creid89/ECE411_Group_Project/Schematics/Prototype V1.png

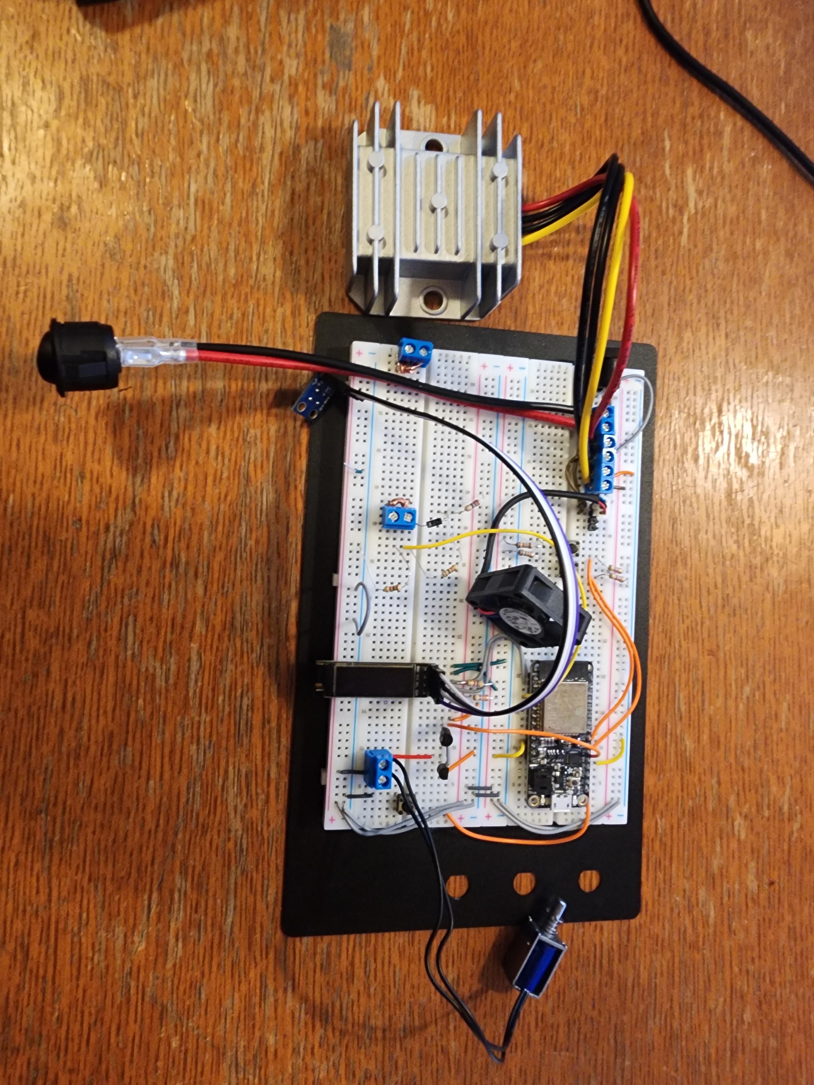
Schematics/Prototype V1.png
