creid89/ECE411_Group_Project/README.md

# ECE411_Group_Project
A repository for our PSU ECE411 Practicum Project
