creid89/ECE411_Group_Project/ESP32 Code/README

Add Revision of ESP32 Code for the ChargeGaurd Pro+ In this Folder
