creid89/ECE411_Group_Project/Weekly HW/Team 2 - 411 - L1 Functional Decomposition.pptx

Level 0

Lithium-Ion charge Button

Level 0
Module | ChargeGuard Pro+
Inputs | Power 12V, Lithium-ion Button, Alkaline button, reset button, Temperature sensor
Output | AA Alkaline battery, Lithium-ion button cell (2032 or 2025) , 12V Fan, LCD indicator
Functionality | Uses 12V power source to charge either a lithium-ion button cell or Alkaline AA batteries. Should include an LCD indicator to display temperature.

AA Alkaline battery

Power 12V

ChargeGuard Pro+

LCD indicator

Reset Button

Fan

Alkaline Button

Lithium-ion button cell (2032/2025)

Temperature sensor

## Slide 2

Level 1 - ChargeGuard Pro+

Start/Stop Switch (AA)

Start/Stop Switch (BC)

Voltage (AA)

Current AA Voltage

Current BC Voltage

SDA/SCL Signal

OLED Screen

User Feedback

Battery Temp

Voltage (BC)

AA Voltage Divider

BC Voltage Divider

Temperature Sensor

Huzzah_ESP32 Module

GPIO Charge Start Signal

SDA/SCL Signal

GPIO Charge Start Signal

Solenoid

AA Charge module

Battery Charge

Reset

BC Charge module

Battery Charge

Power (12V)

Voltage Regulator (5V out)

5VDC

GPIO Battery Eject Signal

Eject AA battery

## Slide 3

AA Voltage Divider: Level 1

AA Voltage Divider

Voltage (AA) ADC (to Huzzah_ESP32)

Voltage (AA)

Level 1
Module | AA Voltage Divider
Inputs | AA Battey Voltage
Output | AA Battery Voltage
Functionality | Use a voltage divider to measure current value of AA battery voltage

## Slide 4

BC Voltage Divider: Level 1

BC Voltage Divider

Voltage (BC) (to Huzzah_ESP32

Voltage (BC)

Level 1
Module | BC Voltage Divider
Inputs | BC Battey Voltage
Output | BC Battery Voltage
Functionality | Use a voltage divider to measure current value of BC battery voltage

## Slide 5

Temperature Sensor: Level 1

Temperature Sensor

5VDC

SDA (to Huzzah_ESP32)

Battery Temperature (°C)

SCL (to Huzzah_ESP32)

Level 1
Module | Temperature Sensor
Inputs | 5VDC (power supply), Battery Temperature measured in °C
Output | SDA/SCL to the Huzzah_ESP32
Functionality | Measure temperature of battery that is currently being charged, read using the ESP32 I2C bus

## Slide 6

OLED Screen: Level 1

OLED Screen

5VDC

Battery Temperature

SDA (from Huzzah_ESP32)

Battery Voltage

SDL (from Huzzah_ESP32)

Current System State

Level 1
Module | OLED Screen
Inputs | 5VDC (power supply), SDA/SCL from the Huzzah_ESP32
Output | Battery temperature, battery voltage
Functionality | Display current system information to user via OLED Screen

## Slide 7

Solenoid: Level 1

Solenoid

GPIO Start Signal

5VDC

Actuating Armature

Level 1
Module | Solenoid
Inputs | 5VDC
Output | Actuating Armature
Functionality | When the battery is done charging, using the armature to eject the charged battery

## Slide 8

Huzzah_ESP32: Level 1

Huzzah_ESP32

Start/Stop Button (BC)

Start/Stop Button (AA)

Solenoid Start/Stop Signal

BC Battery Voltage

BC Charge Module Start/Stop Signal

AA Battery Voltage

AA Charge Module Start/Stop Signal

SDA/SCL From Temp Sensor

RESET

SDA/SDL to OLED

5 VDC

Level 1
Module | Huzzah_ESP32
Inputs | Start/Stop Charge Button (Qty. (1) for each AA and BC batteries), BC/AA Current Voltage, SDA/SCL from temp sensor, Reset, 5VDC from regulator to power uC
Output | Solenoid start/stop signal, BC and AA charge module Start/Stop charging signal, SDA/SCL to user OLED display
Functionality | Continuously read and store current values for temperature, voltage, and button states. Send signals to start/stop charging based on input thresholds and system state. Display real-time system status: temperature, voltage, charging state, and errors. Transition between states (e.g., charging, waiting, error) based on input conditions and thresholds.

## Slide 9

Voltage Regulator : Level 1

Voltage Regulator

12 VDC

5 VDC

Level 1
Module | Voltage Regulator
Inputs | 12 VDC (from 12VDC wall wart)
Output | 5 VDC
Functionality | Steps down 12VDC input to a stable 5VDC output.

## Slide 10

AA Charge Module: Level 1

AA Charge Module

GPIO Pin Start Signal (From Huzzah_ESP32

(1.3 – 1.6) VDC

Level 1
Module | AA Charging Module
Inputs | Start Charging Signal
Output | (1.3 – 1.6) VDC Charging Voltage
Functionality | Starts charging AA battery when a start signal comes from the Huzzah_ESP32

## Slide 11

BC Charge Module: Level 1

BC Charge Module

GPIO Pin Start Signal (From Huzzah_ESP32

4.2 VDC

Level 1
Module | BC Charging Module
Inputs | Start Charging Signal
Output | 4.2 VDC Charging Voltage
Functionality | Starts charging BC battery when a start signal comes from the Huzzah_ESP32
