creid89/ECE411_Group_Project/Weekly Progress Reports (WPRs)/Progress Report - Week 7 .pdf

## Progress Report - Week 7 | Nov. 9, 2024

Group 2:

Cody Reid
Cuauhtemoc Gomez Angeles
Daniel Anishchenko
Tyler Tran

This Week’s Assignments:
- Updated CAD
- Bill of Materials
- Functional Decomp

Meeting Notes:
- Currently testing a larger OLED screen, will decide later as a team if the smaller one will be replaced
- Gantt chart should be finished by 12:30 am - Nov. 2
- Work is divided as follows
- Cody is to work on functional Decomposition
- Tyler is to work on the BOM
- Daniel is working on the breadboard
- Vincente is working on the BOM and CAD

Completed Tasks:
- Updated CAD - completed Nov. 9
- Bill of Materials - completed Nov.11
- Functional Decomp - completed Nov. 9 Tasks at Hand (Priority High to Low):
- Start finalizing code
- Start on final PCB CAD
- Revise 2nd phase prototype casing
