creid89/ECE411_Group_Project/Component Info/README

A place to store components informations such as technical documnentation, pinouts, ect
