creid89/ECE411_Group_Project/Schematics/Screen Cover V2.stl

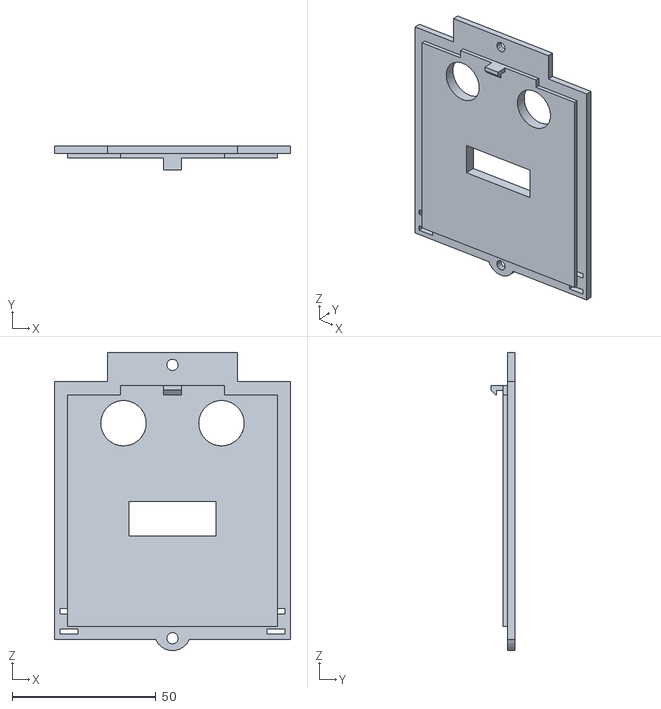
[picture p5: CAD file, 2024-12-10]
Schematics/Screen Cover V2.stl
82.3 x 8.33 x 103.8
