creid89/ECE411_Group_Project/Schematics/Battery Terminal Bracket V1 PRINT NOW 12-4-2024.stl

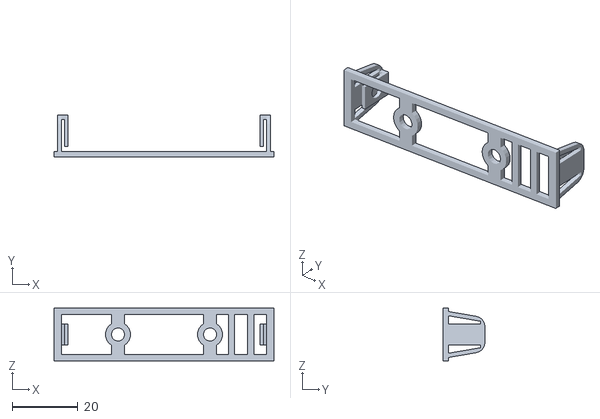
[picture p6: CAD file, 2024-12-05]
Schematics/Battery Terminal Bracket V1 PRINT NOW 12-4-2024.stl
66.8 x 12.7 x 16.0
