creid89/ECE411_Group_Project/Schematics/Bottom Legs - Print now 11-30-2024.stl

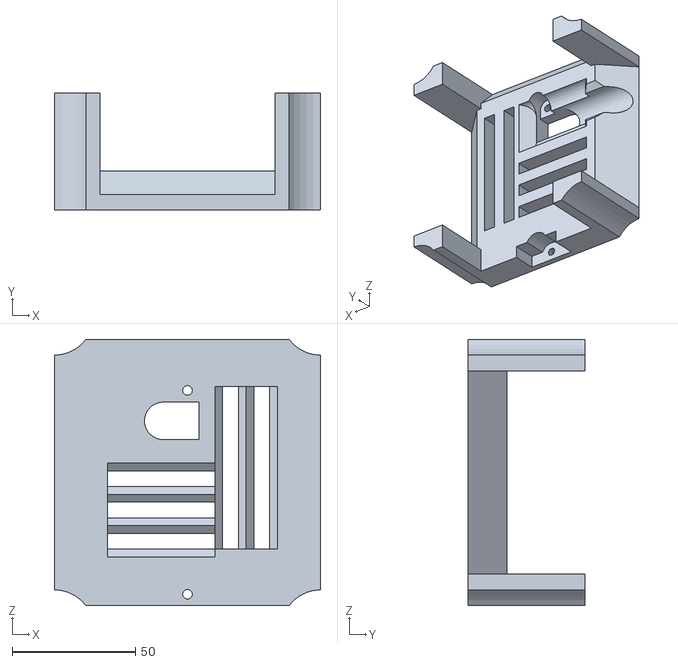
[picture p7: CAD file, 2024-11-30]
Schematics/Bottom Legs - Print now 11-30-2024.stl
107.9 x 47.6 x 108.0
