creid89/ECE411_Group_Project/Schematics/Legs V1.stl

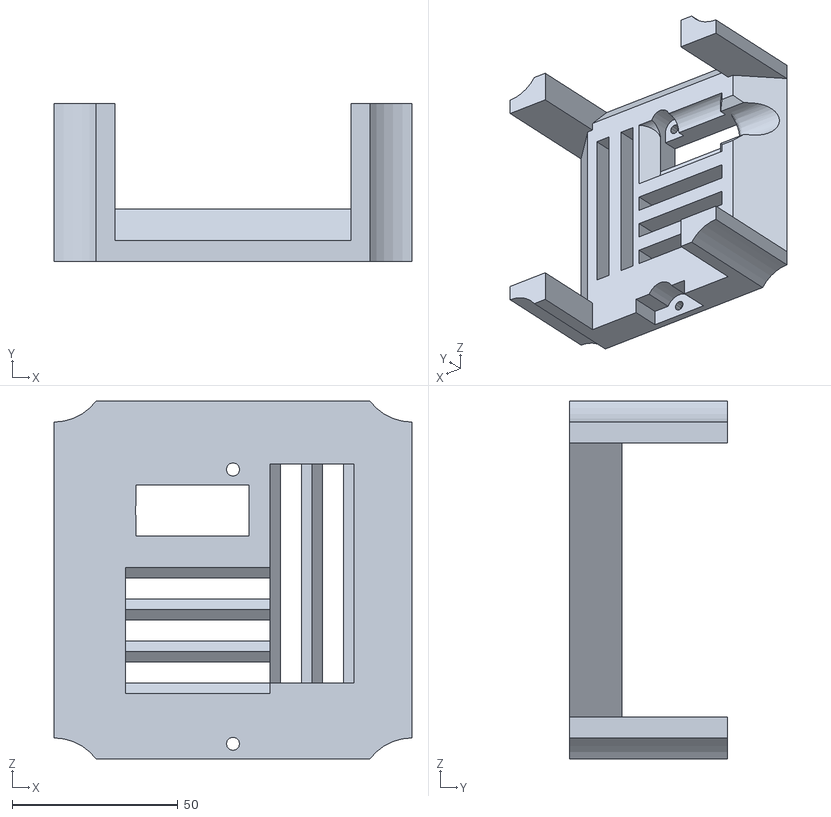
[picture p8: CAD file, 2024-11-20]
Schematics/Legs V1.stl
107.9 x 47.6 x 108.0
