creid89/ECE411_Group_Project/Schematics/Housing Bottom V3.stl

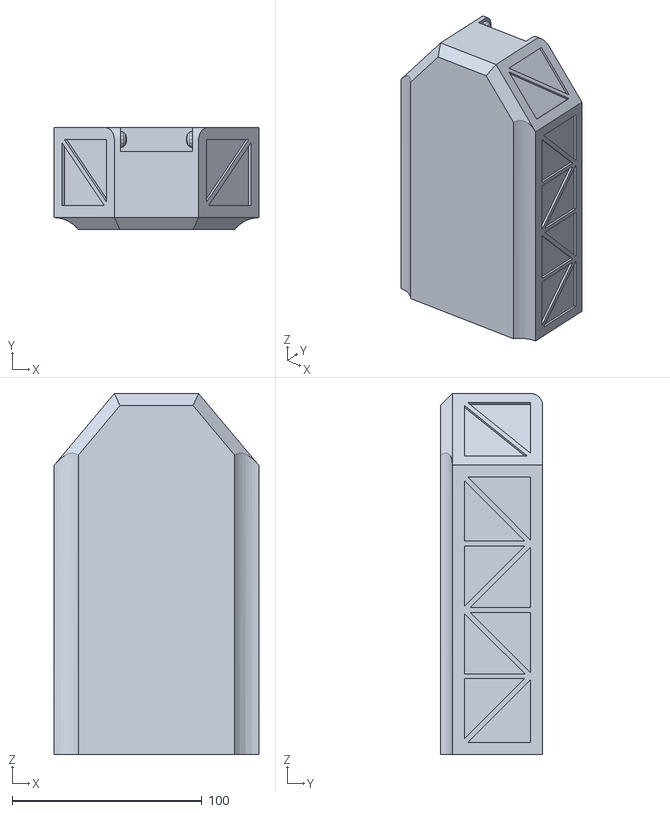
[picture p9: CAD file, 2024-11-20]
Schematics/Housing Bottom V3.stl
107.9 x 54.0 x 190.5
