creid89/ECE411_Group_Project/Schematics/Grid V3.stl

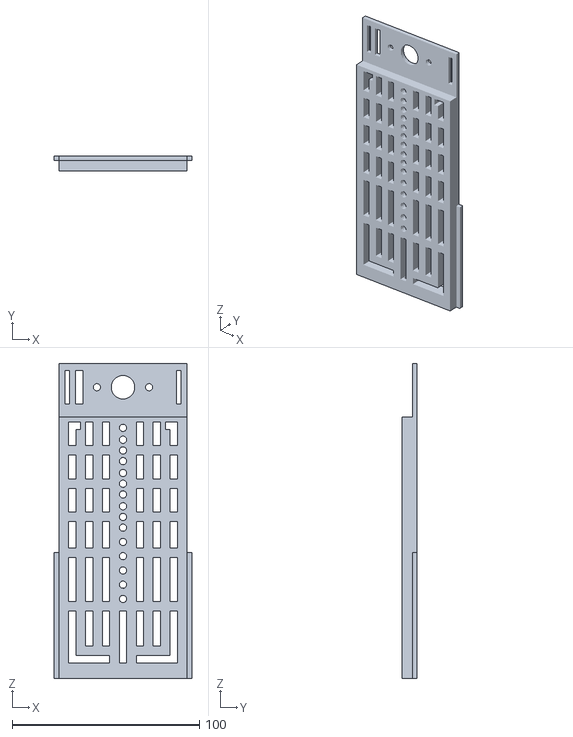
[picture p10: CAD file, 2024-11-20]
Schematics/Grid V3.stl
73.7 x 8.26 x 168.4
