creid89/ECE411_Group_Project/Schematics/Housing Top V2.stl

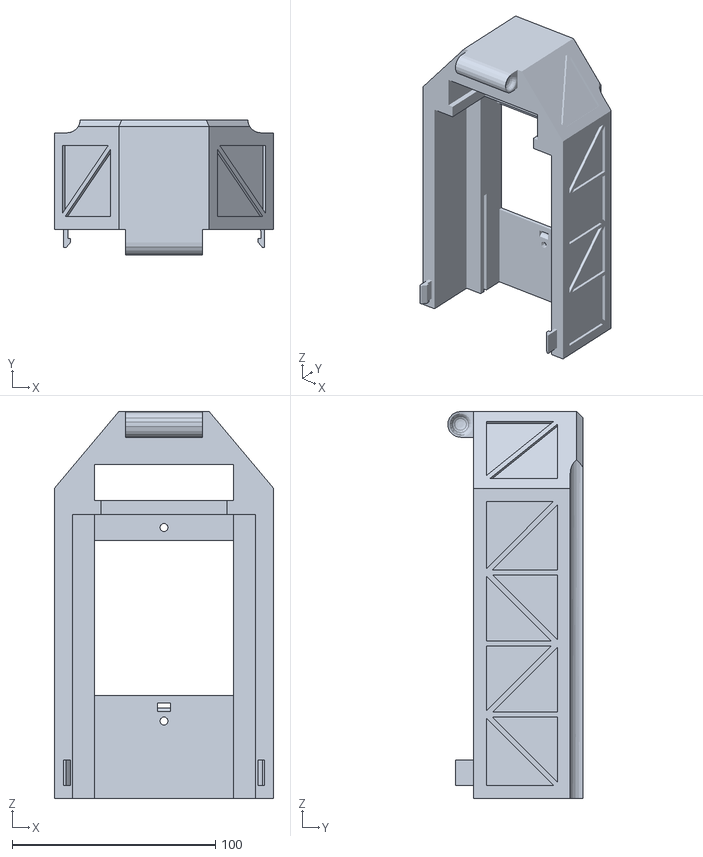
[picture p11: CAD file, 2024-11-20]
Schematics/Housing Top V2.stl
107.9 x 66.6 x 190.5
