creid89/ECE411_Group_Project/Schematics/Housing V2.stl

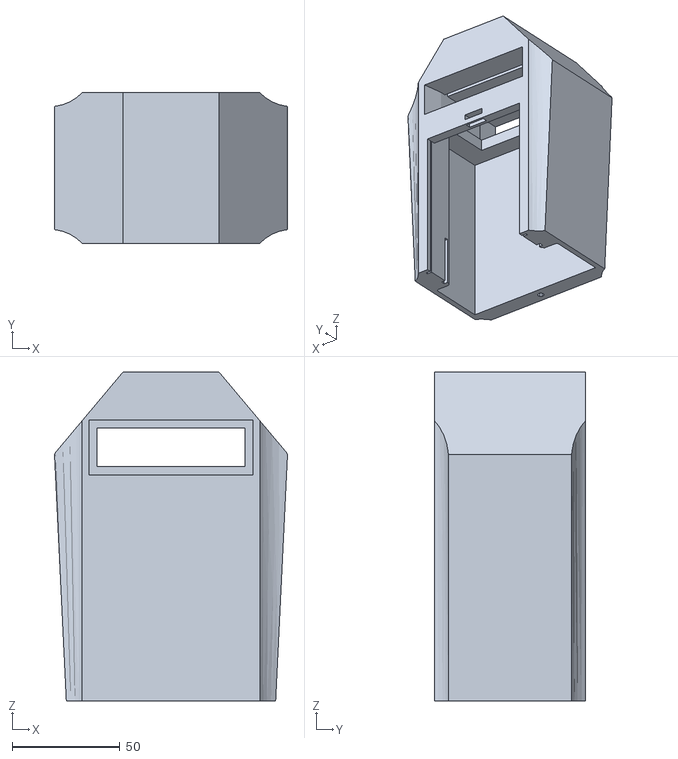
[picture p12: CAD file, 2024-11-17]
Schematics/Housing V2.stl
107.9 x 69.8 x 152.4
