creid89/ECE411_Group_Project/Schematics/Grid V2.stl

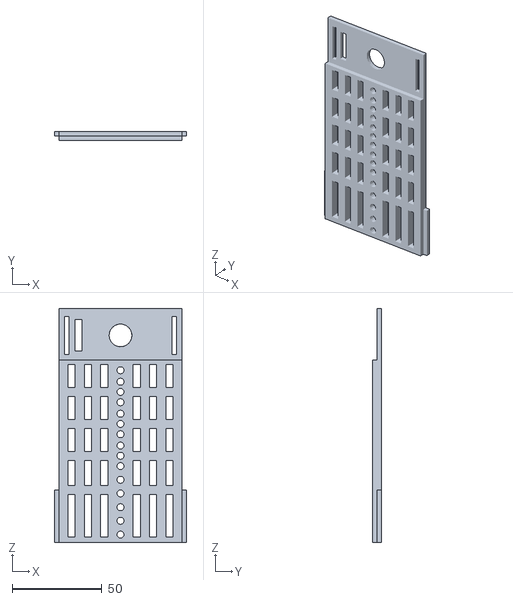
[picture p13: CAD file, 2024-11-17, an earlier design]
Schematics/Grid V2.stl
73.7 x 5.08 x 130.3
