creid89/ECE411_Group_Project/(list of files, cad)

Other CAD files:
Schematics/Housing Bottom V2.stl
