creid89/ECE411_Group_Project/Schematics/ChargeGuard_Pro_Plus_ECE411 - 1.0.6.pdf

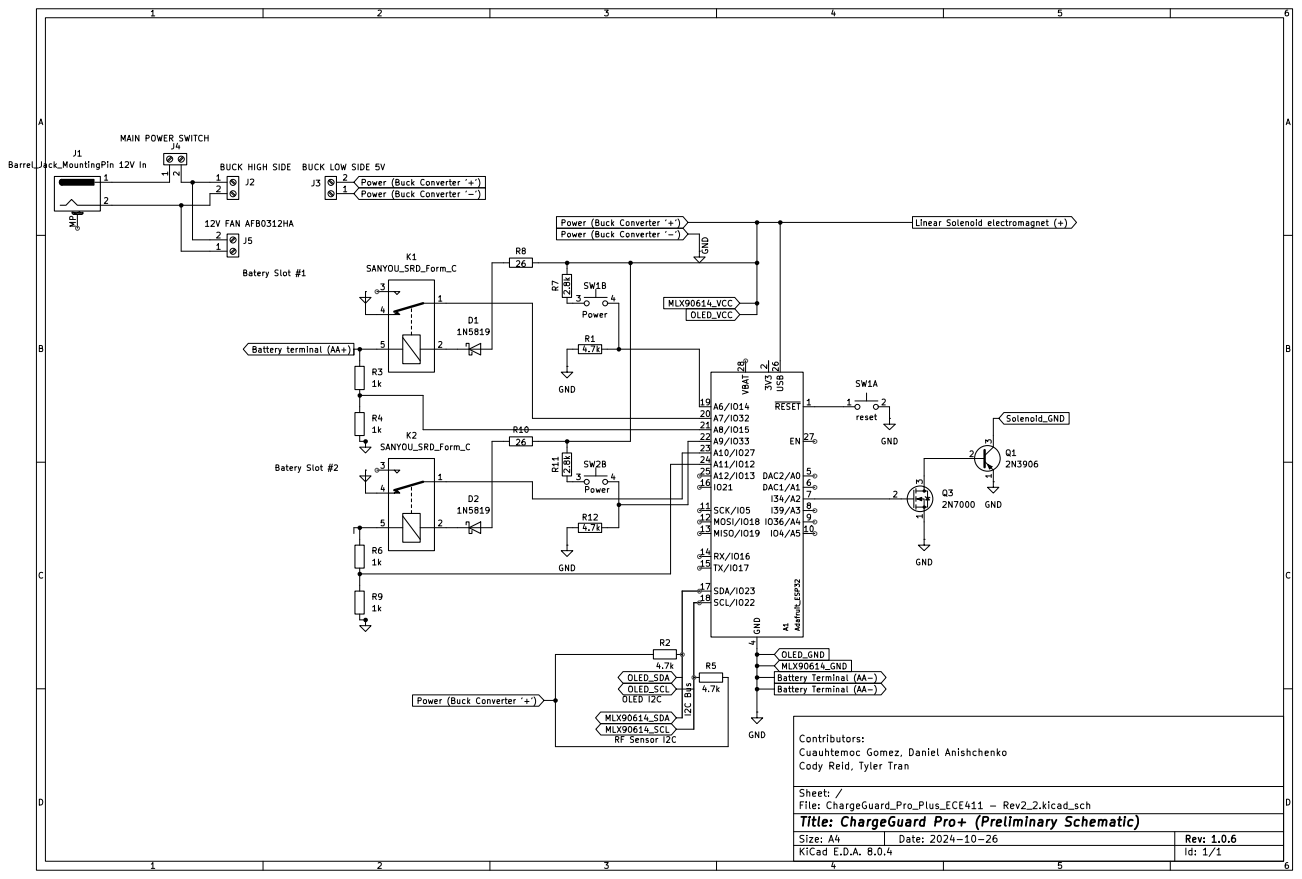
[picture p14: page 1]
