creid89/ECE411_Group_Project/Schematics/Preliminaty Schematic.pdf

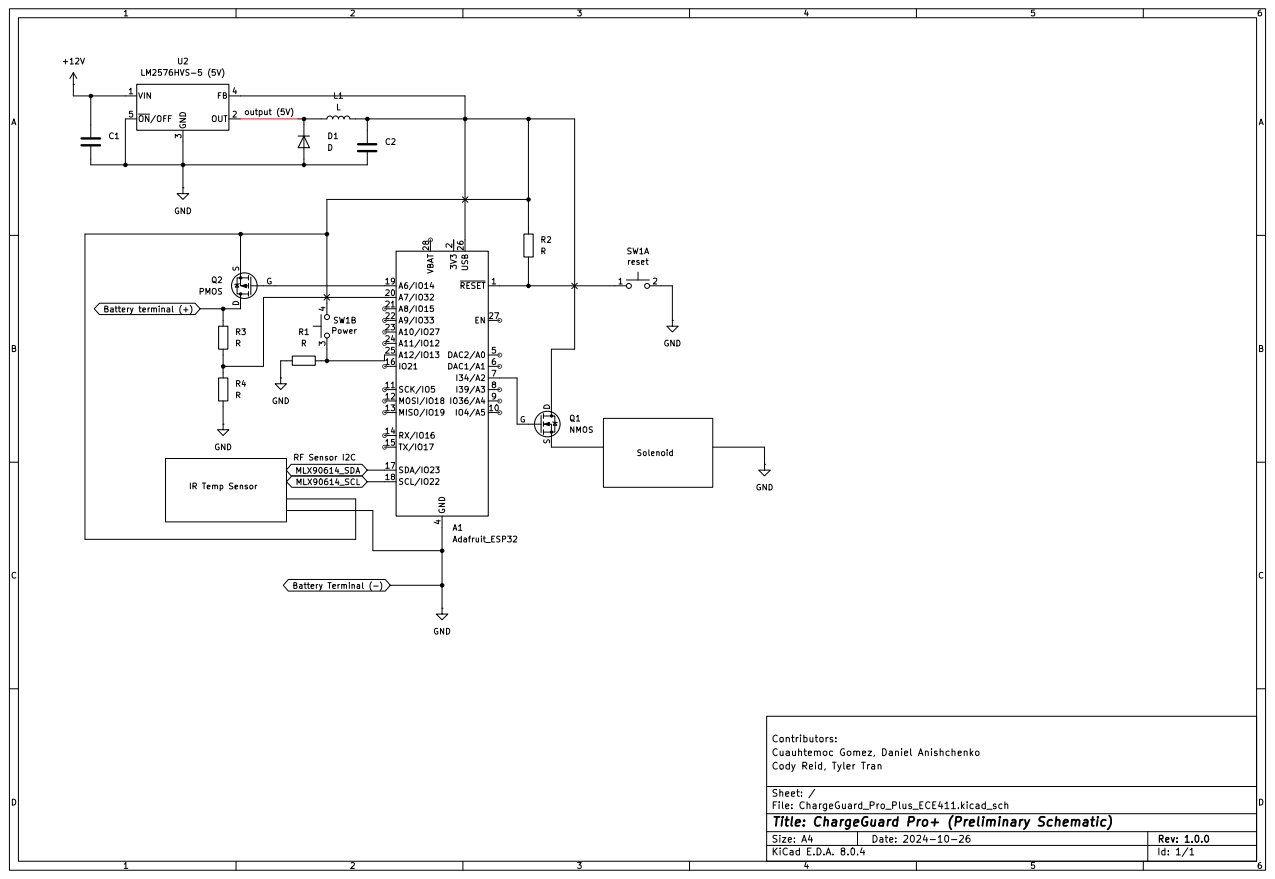
[picture p15: page 1]
