creid89/ECE411_Group_Project/Schematics/PCB Design + Bill/CAD - ChargeGuard PRO +.pdf

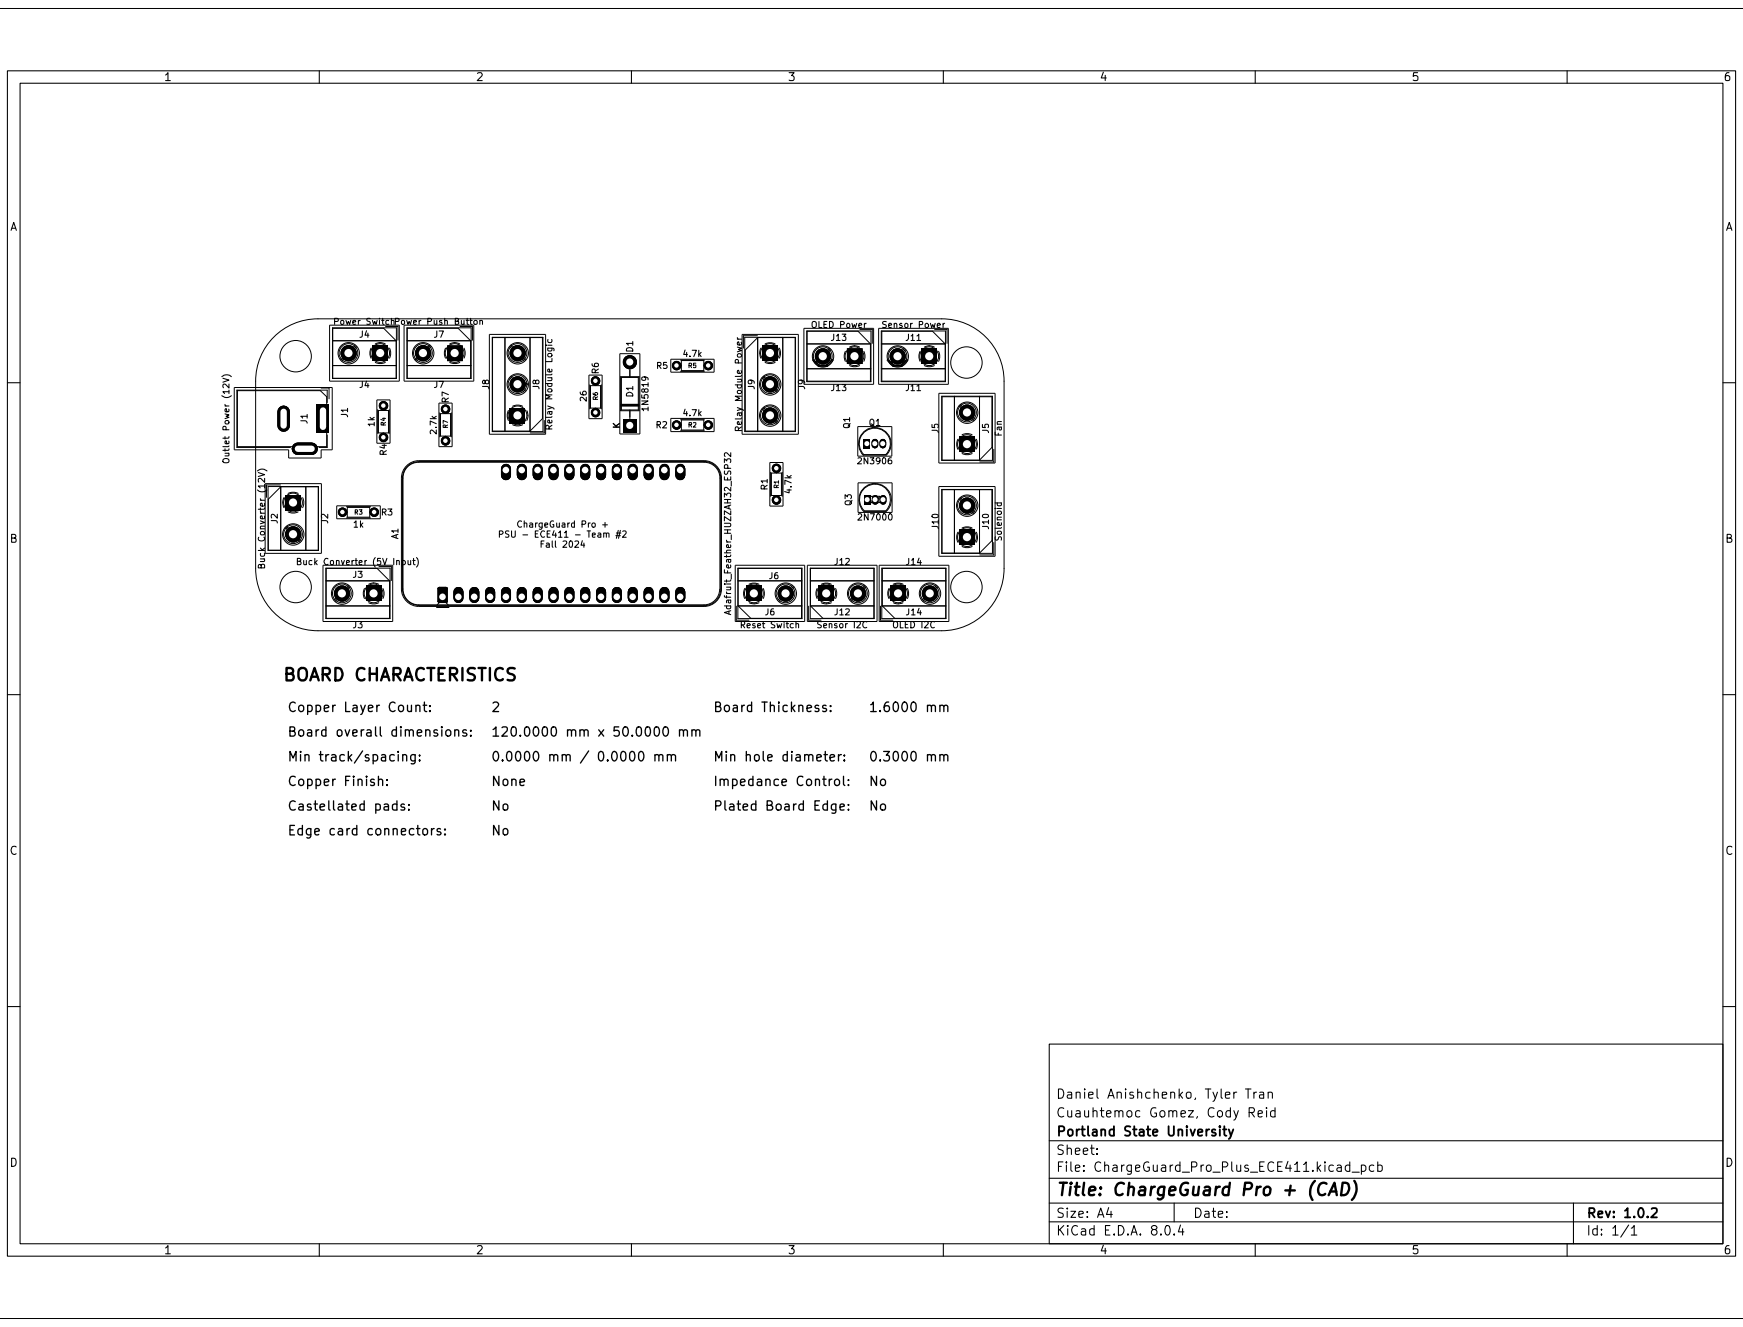
[picture p16: page 1]
