creid89/ECE411_Group_Project/Schematics/PCB Design + Bill/CHargeGuard Pro+.pdf

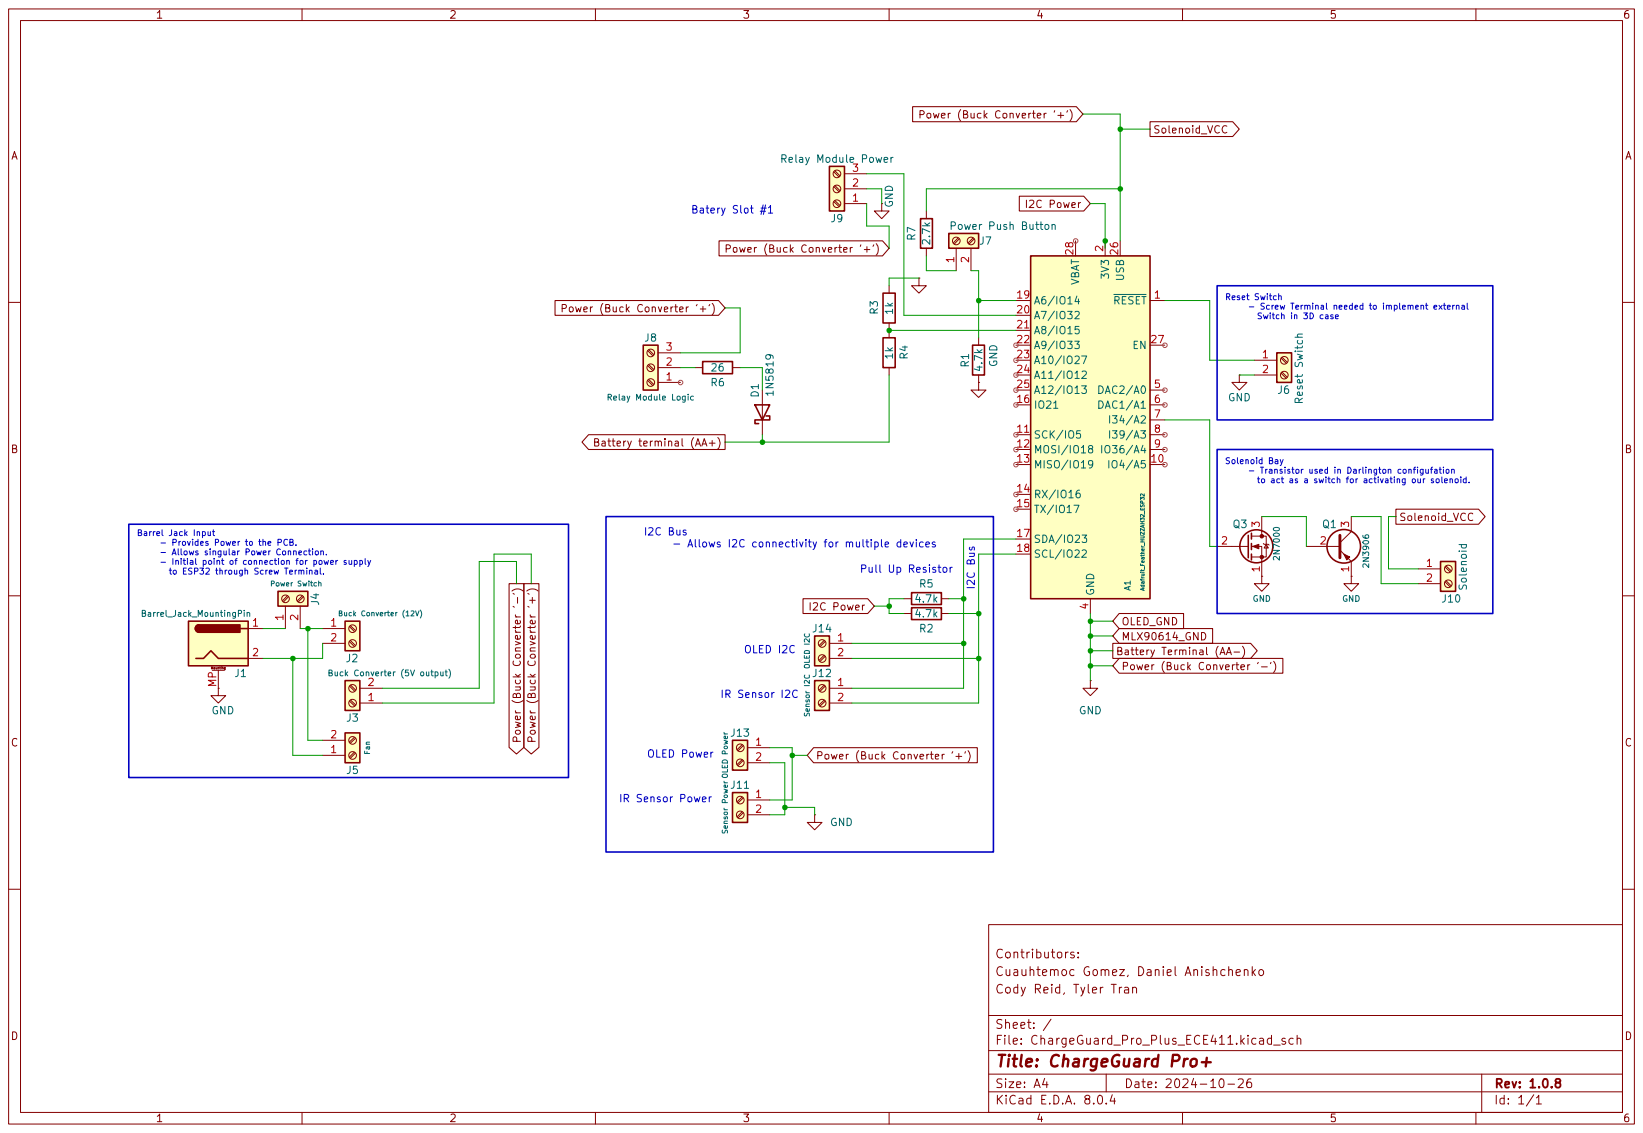
[picture p17: page 1]
