creid89/ECE411_Group_Project/Schematics/Schematics/ChargeGuard Pro ++ (CAD).pdf

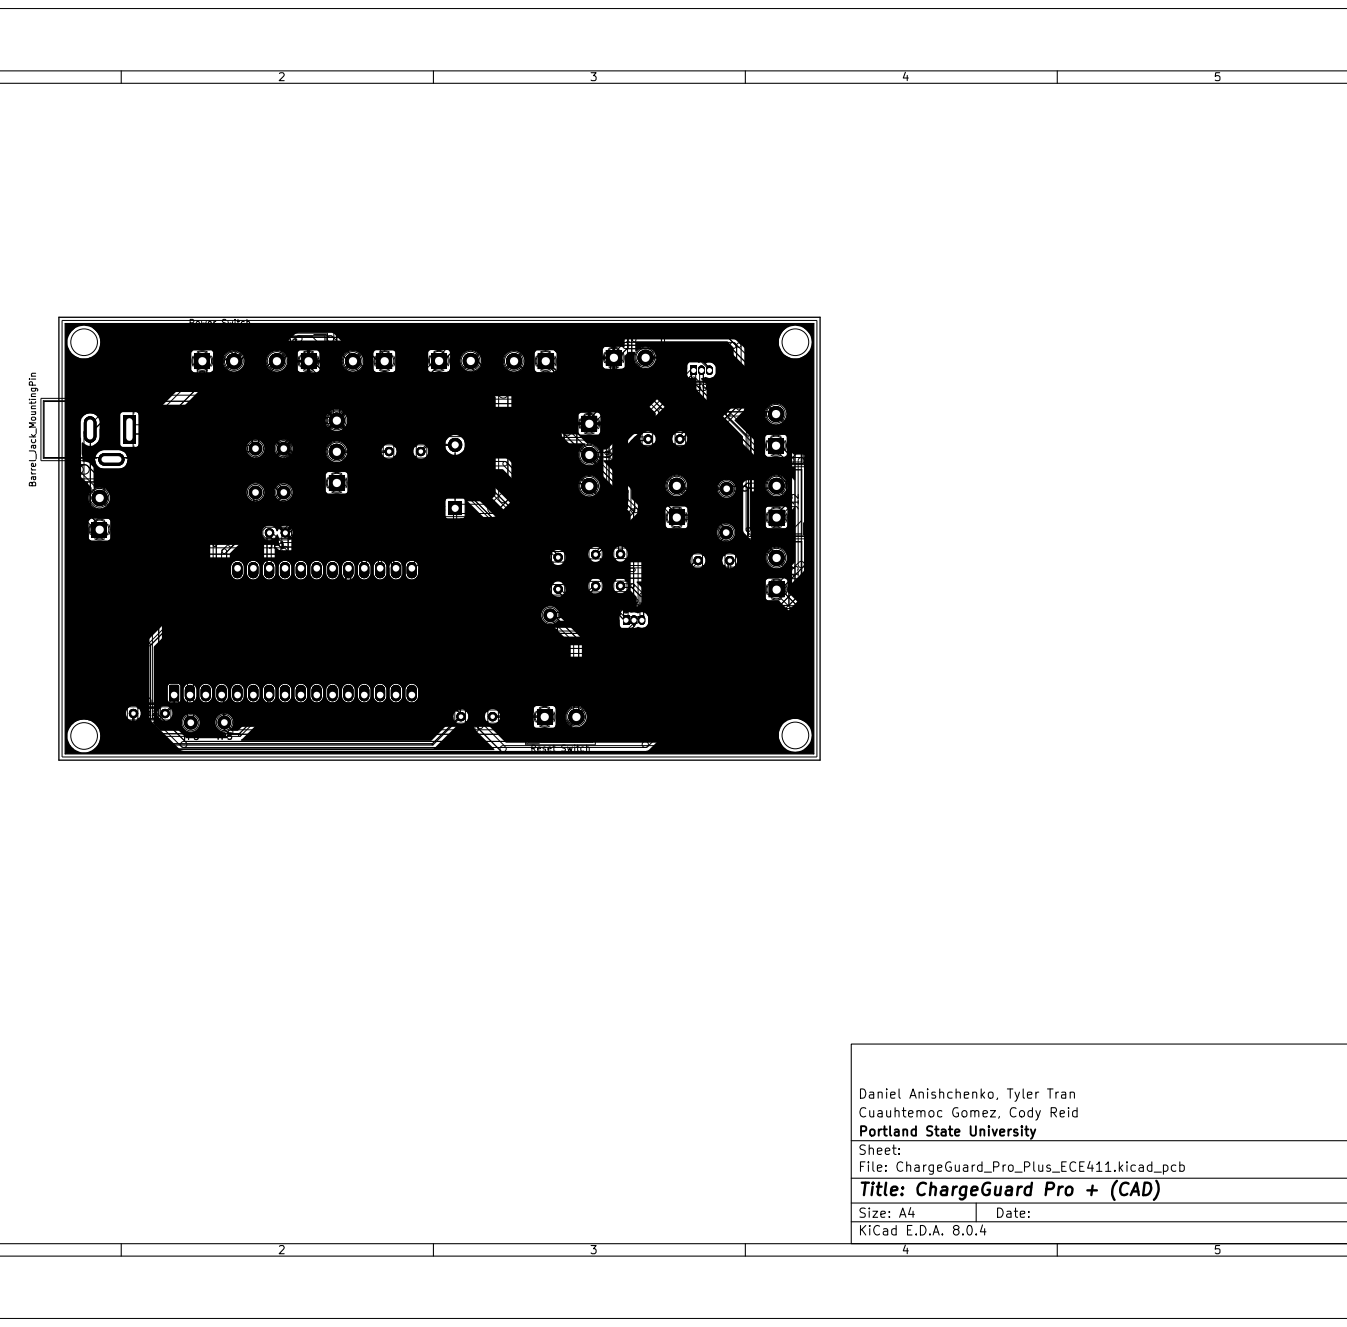
[picture p18: page 1]
