creid89/ECE411_Group_Project/Schematics/Schematics/ChargeGuard Pro+(1.0.8).pdf

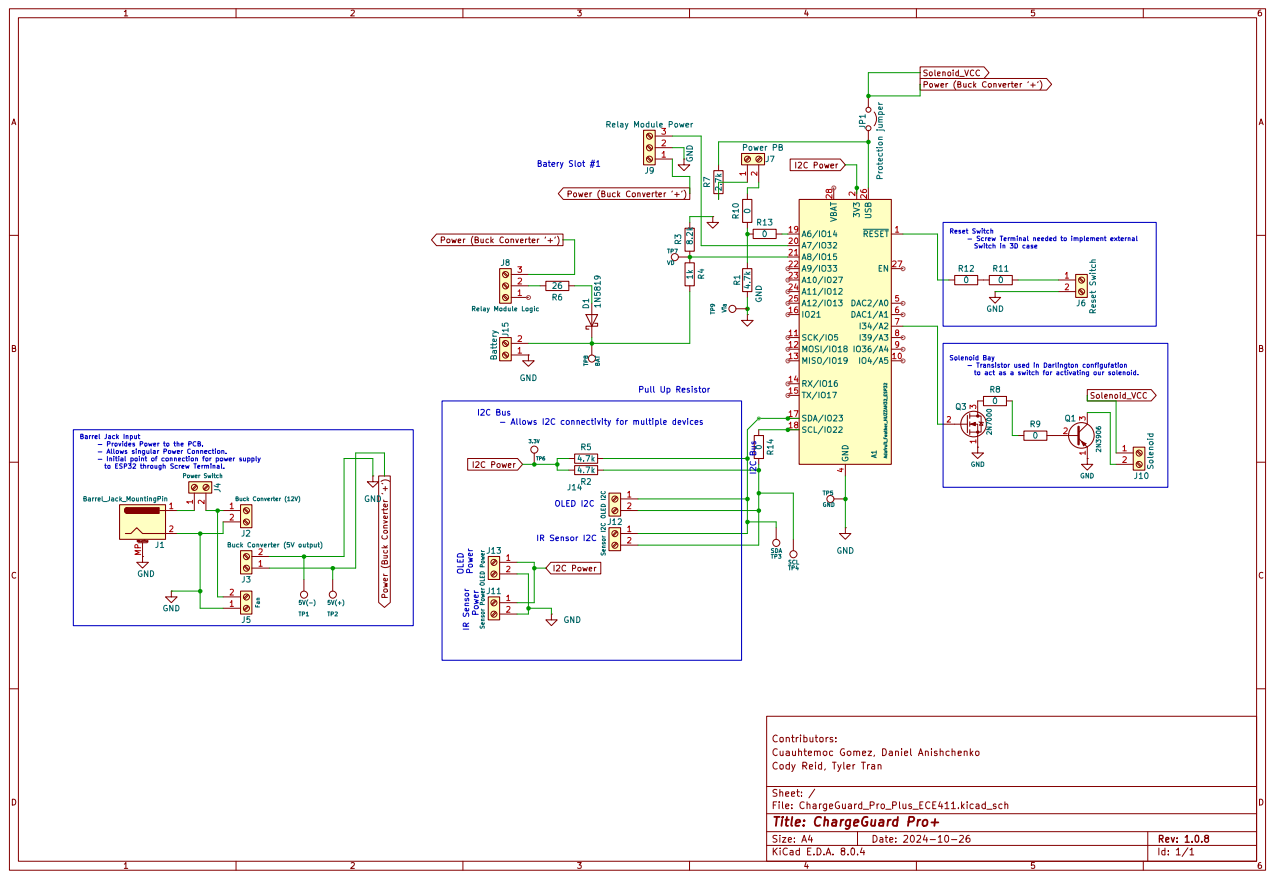
[picture p19: page 1]
