creid89/ECE411_Group_Project/Schematics/Schematics/ChargeGuard_Pro_Plus_ECE411 - 1.0.1.pdf

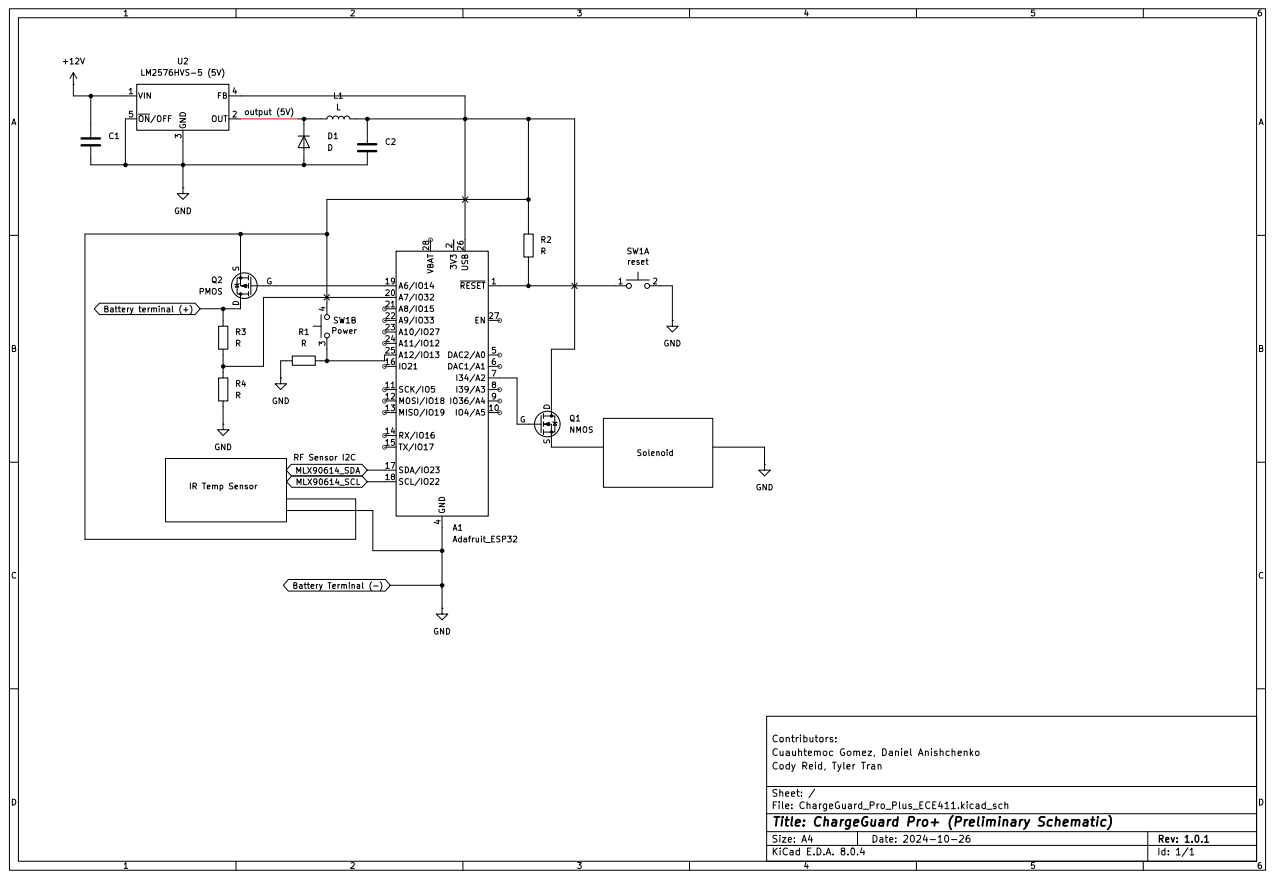
[picture p20: page 1]
