creid89/ECE411_Group_Project/Schematics/Schematics/ChargeGuard_Pro_Plus_ECE411 - 1.0.3.pdf

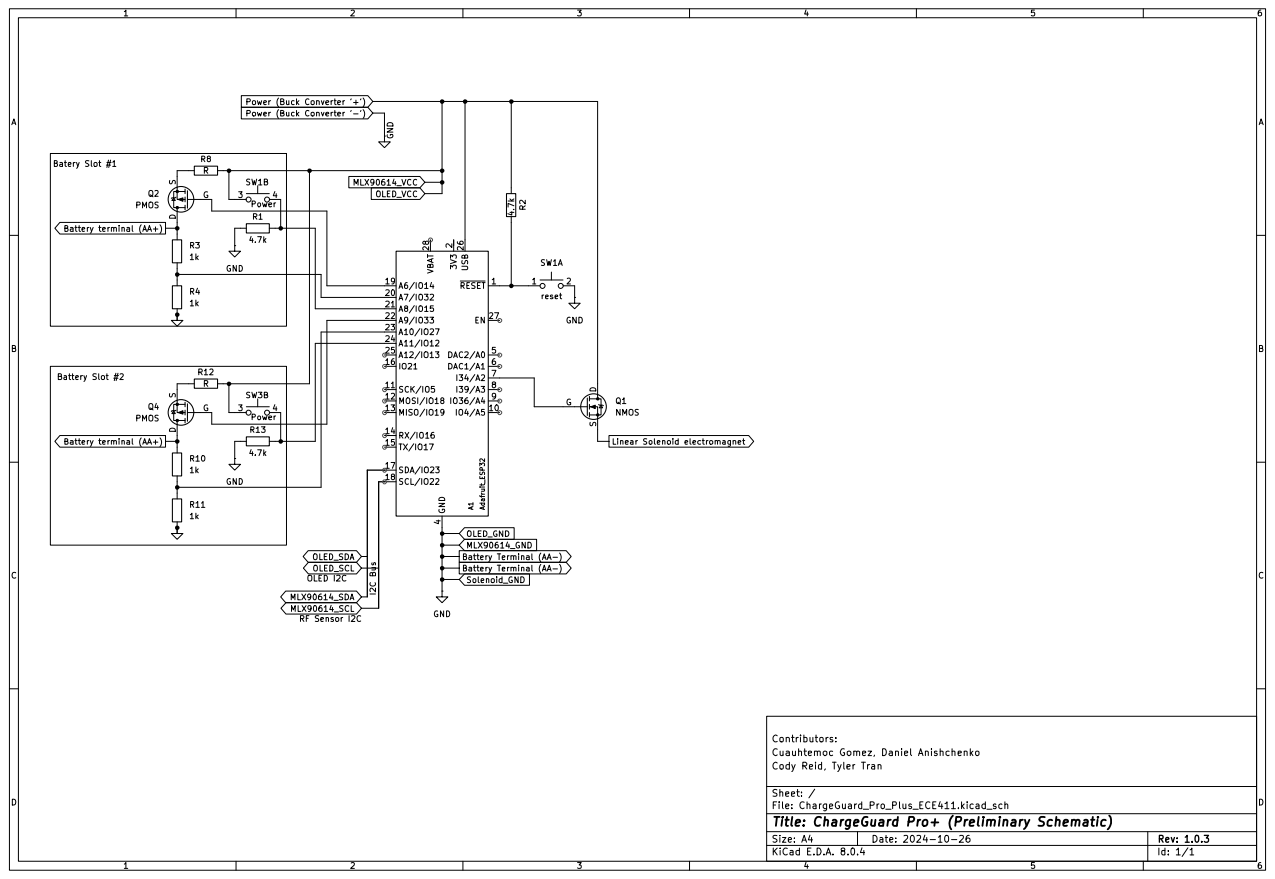
[picture p21: page 1]
