creid89/ECE411_Group_Project/Schematics/Schematics/ChargeGuard_Pro_Plus_ECE411 - 1.0.4.pdf

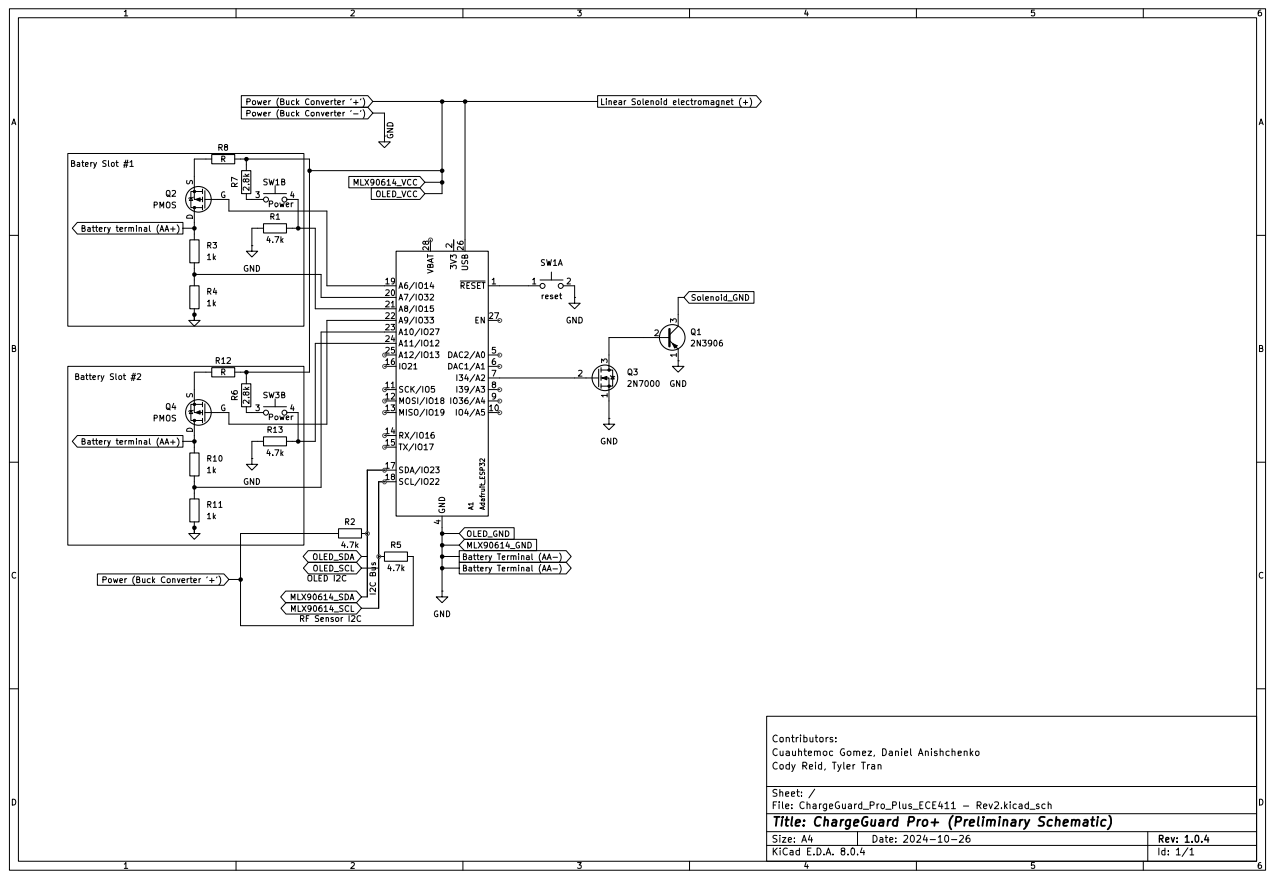
[picture p22: page 1]
