creid89/ECE411_Group_Project/Schematics/Schematics/ChargeGuard_Pro_Plus_ECE411 - 1.0.5.pdf

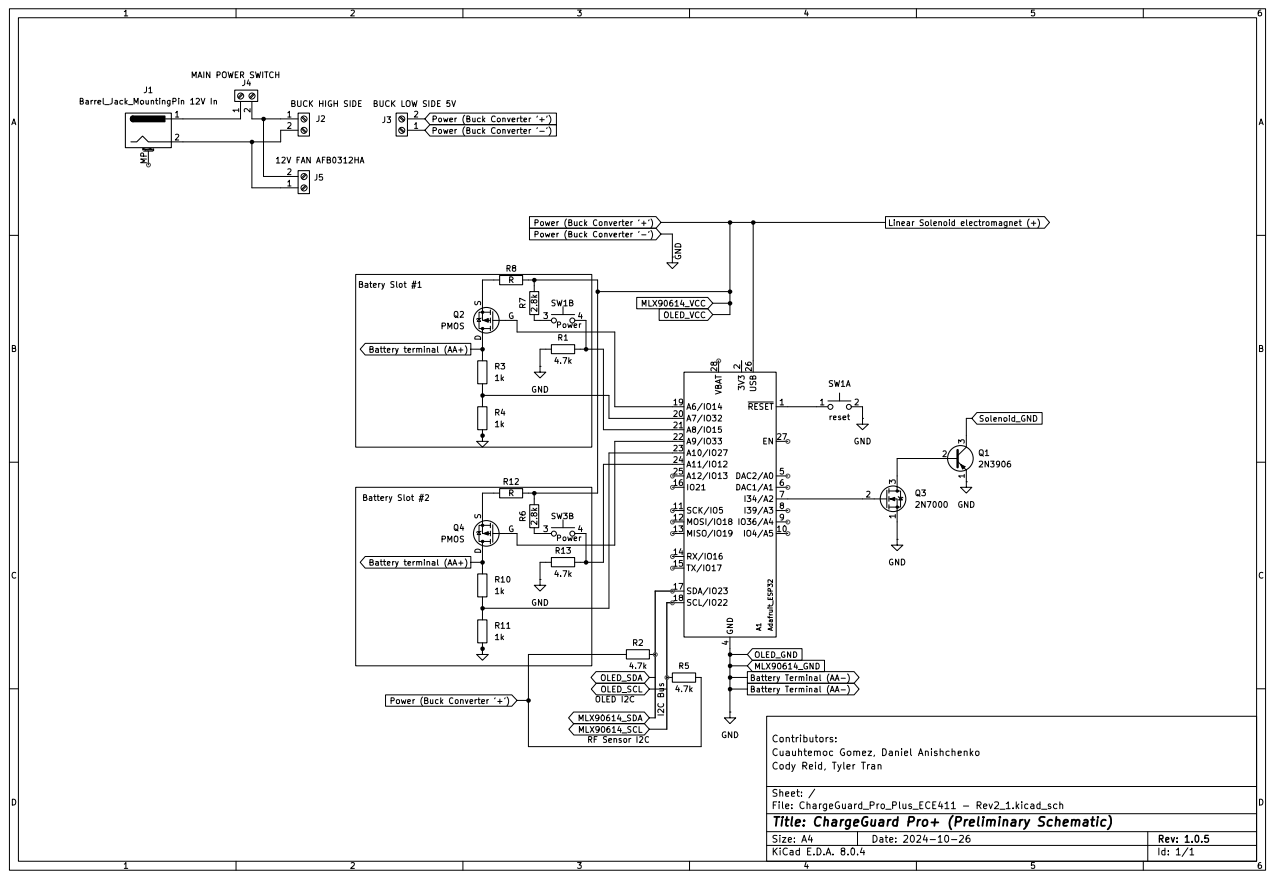
[picture p23: page 1]
