creid89/ECE411_Group_Project/Schematics/ChargeGuard_Pro_Plus_ECE411/ChargeGuard_Pro_Plus_ECE411.kicad_pcb

## KiCad design Schematics/ChargeGuard_Pro_Plus_ECE411/ChargeGuard_Pro_Plus_ECE411.kicad_pcb (2024-11-22)

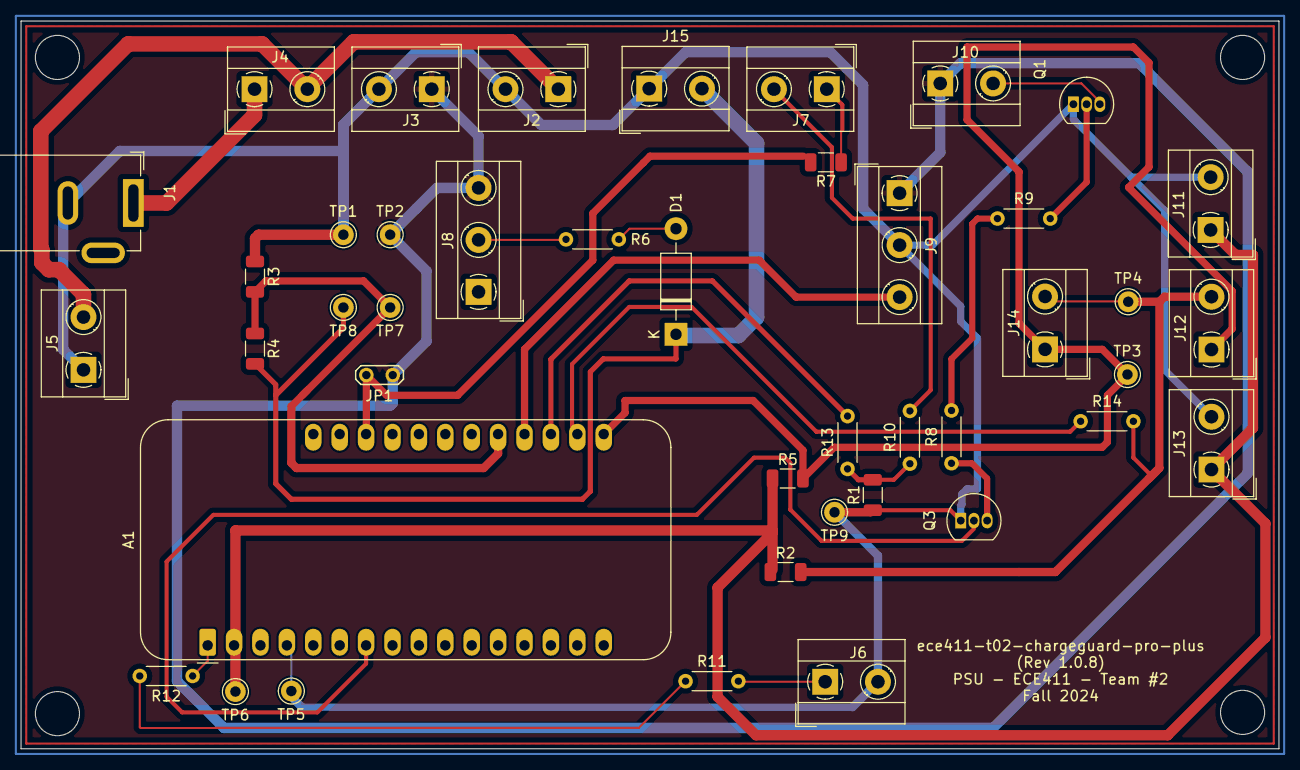
[picture p24: board ChargeGuard_Pro_Plus_ECE411.kicad_pcb from above]

Board: 2 copper layers, 121.0 x 70.0 mm, 43 parts (0 on the bottom side), 26 nets.

Parts:
A1: Adafruit_Feather_HUZZAH32_ESP32; Adafruit_Feather
D1: 1N5819; D_DO-41_SOD81_P10.16mm_Horizontal
J1: Barrel_Jack_MountingPin; BarrelJack_GCT_DCJ200-10-A_Horizontal
J2: Buck Converter (12V); TerminalBlock_MetzConnect_Type101_RT01602HBWC_1x02_P5.08mm_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
J3: Buck Converter (5V output); TerminalBlock_MetzConnect_Type101_RT01602HBWC_1x02_P5.08mm_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
J4: Power Switch; TerminalBlock_MetzConnect_Type101_RT01602HBWC_1x02_P5.08mm_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
J5: Fan; TerminalBlock_MetzConnect_Type101_RT01602HBWC_1x02_P5.08mm_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
J6: Reset Switch; TerminalBlock_MetzConnect_Type101_RT01602HBWC_1x02_P5.08mm_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
J7: Power PB; TerminalBlock_MetzConnect_Type101_RT01602HBWC_1x02_P5.08mm_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
J8: Relay Module Logic; TerminalBlock_MetzConnect_Type055_RT01503HDWU_1x03_P5.00mm_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
J9: Relay Module Power; TerminalBlock_MetzConnect_Type055_RT01503HDWU_1x03_P5.00mm_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
J10: Solenoid; TerminalBlock_MetzConnect_Type101_RT01602HBWC_1x02_P5.08mm_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
J11: Sensor Power; TerminalBlock_MetzConnect_Type101_RT01602HBWC_1x02_P5.08mm_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
J12: Sensor I2C; TerminalBlock_MetzConnect_Type101_RT01602HBWC_1x02_P5.08mm_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
J13: OLED Power; TerminalBlock_MetzConnect_Type101_RT01602HBWC_1x02_P5.08mm_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
J14: OLED I2C; TerminalBlock_MetzConnect_Type101_RT01602HBWC_1x02_P5.08mm_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
J15: Battery; TerminalBlock_MetzConnect_Type101_RT01602HBWC_1x02_P5.08mm_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
JP1: Protection jumper; TestPoint_2Pads_Pitch2.54mm_Drill0.8mm
Q1: 2N3906; TO-92_Inline
Q3: 2N7000; TO-92_Inline
R1, R2, R5: 4.7k; R_1206_3216Metric
R3: 8.2k; R_1206_3216Metric
R4: 1k; R_1206_3216Metric
R6: 26; R_Axial_DIN0204_L3.6mm_D1.6mm_P5.08mm_Horizontal
R7: 2.7k; R_1206_3216Metric
R8, R9, R10, R11, R12, R13, R14: 0; R_Axial_DIN0204_L3.6mm_D1.6mm_P5.08mm_Horizontal
TP1: 5V(-); Pin_D1.0mm_L10.0mm
TP2: 5V(+); Pin_D1.0mm_L10.0mm
TP3: SDA; Pin_D1.0mm_L10.0mm
TP4: SCL; Pin_D1.0mm_L10.0mm
TP5: GND; Pin_D1.0mm_L10.0mm
TP6: 3.3V; Pin_D1.0mm_L10.0mm
TP7: VD; Pin_D1.0mm_L10.0mm
TP8: BAT; Pin_D1.0mm_L10.0mm
TP9: Via; Pin_D1.0mm_L10.0mm

Connections:
GND: A1.4 (GND), J1.2, J2.2, J3.2, J5.1, J6.2, J9.2, J11.2, J13.2, J15.1, Q1.1 (E), Q3.1 (S), R1.1, R3.1, TP1.1, TP5.1, TP9.1
I2C Power: A1.2 (3V3), J11.1, J13.1, R2.1, R5.1, TP6.1
unnamed: A1.19 (A6/IO14), R13.2
unnamed: A1.20 (A7/IO32), J9.3
unnamed: A1.21 (A8/IO15), R3.2, R4.1, TP7.1
unnamed: A1.7 (I34/A2), Q3.2 (G)
unnamed: A1.18 (SCL/IO22), R14.1
unnamed: A1.17 (SDA/IO23), J12.1, J14.1, R5.2, TP3.1
unnamed: A1.26 (USB), JP1.2 (B), R7.2
unnamed: A1.1 (~RESET), R12.1
unnamed: D1.2 (A), R6.1
unnamed: D1.1 (K), J15.2, R4.2, TP8.1
unnamed: J2.1, J4.2, J5.2
unnamed: J1.1, J4.1
unnamed: J6.1, R11.2
unnamed: J7.1, R7.1
unnamed: J7.2, R10.2
unnamed: J8.2, R6.2
unnamed: J10.2, Q1.3 (C)
unnamed: J12.2, J14.2, R2.2, R14.2, TP4.1
unnamed: Q1.2 (B), R9.2
unnamed: Q3.3 (D), R8.1
unnamed: R1.2, R10.1, R13.1
unnamed: R8.2, R9.1
unnamed: R11.1, R12.2
Power (Buck Converter '+'): J3.1, J8.3, J9.1, J10.1, JP1.1 (A), TP2.1
