creid89/ECE411_Group_Project/(commit log)

2024-11-08 Add files via upload
    Preliminary Schematic and most up to date Schematic of CHargue Guard Pro
2024-11-08 Add files via upload
    Breadboard Prototype
2024-11-08 Rename signal-2024-11-07-205029.jpeg to Prototype V1
2024-11-08 Rename Prototype V1 to Prototype V1.png
2024-11-09 Create Bill of Materials (BOM)
2024-11-09 Create Bill of Materials
2024-11-16 Add files via upload
    ChargeGuard Pro ++ Folder with all previous and concurrent information
    [ChargeGuard_Pro_Plus_ECE411.kicad_pcb, ChargeGuard_Pro_Plus_ECE411.kicad_sch]
2024-11-19 Add files via upload
    Updated Version of Schematic as well as PCB Design
    [ChargeGuard_Pro_Plus_ECE411.kicad_pcb, ChargeGuard_Pro_Plus_ECE411.kicad_sch]
2024-11-20 ChargeGuard Pro + - 11/20/2024
    [ChargeGuard_Pro_Plus_ECE411.kicad_pcb, ChargeGuard_Pro_Plus_ECE411.kicad_sch]
2024-11-22 ChargeGuard Pro + - 11/21/2024
    [ChargeGuard_Pro_Plus_ECE411-B_Cu.gbr, ChargeGuard_Pro_Plus_ECE411-B_Mask.gbr, ChargeGuard_Pro_Plus_ECE411-B_Paste.gbr, ChargeGuard_Pro_Plus_ECE411-B_Silkscreen.gbr, ChargeGuard_Pro_Plus_ECE411-Edge_Cuts.gbr, ChargeGuard_Pro_Plus_ECE411-F_Cu.gbr, ChargeGuard_Pro_Plus_ECE411-F_Mask.gbr, ChargeGuard_Pro_Plus_ECE411-F_Paste.gbr]
2024-11-22 BOM + Fab
2024-12-12 BOM - Revision 1.2
    [ChargeGuard Pro+ - ECE411 Practicum - Bill of Materials rev1.2.xlsx]
2024-12-12 OSH Park - PCB layers/ChargeGuard Pro +
